Ritwik-main/ESC-tools/circuit_image.png

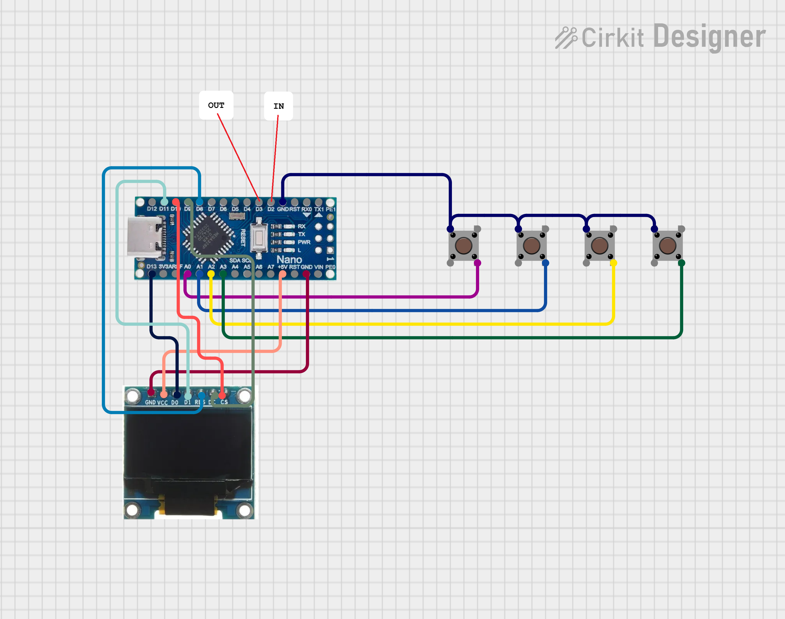
circuit_image.png
