Ritwik-main/ESC-tools/waveforms/0 duty.png

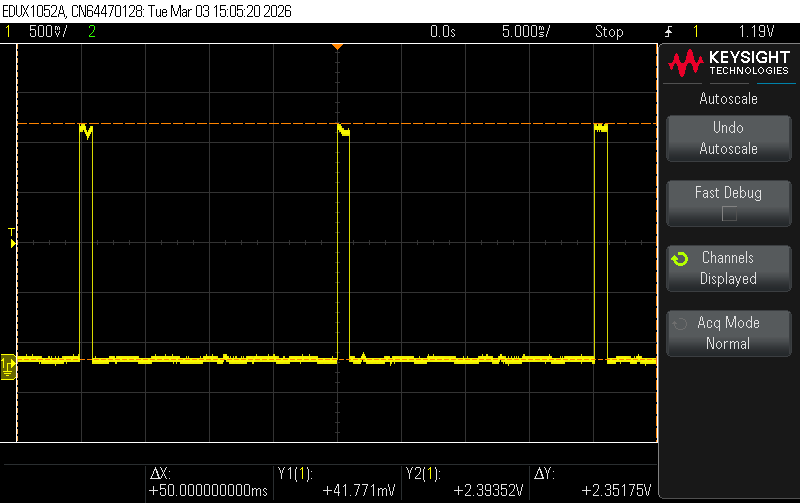
waveforms/0 duty.png
