Ritwik-main/ESC-tools/waveforms/1 Khz.png

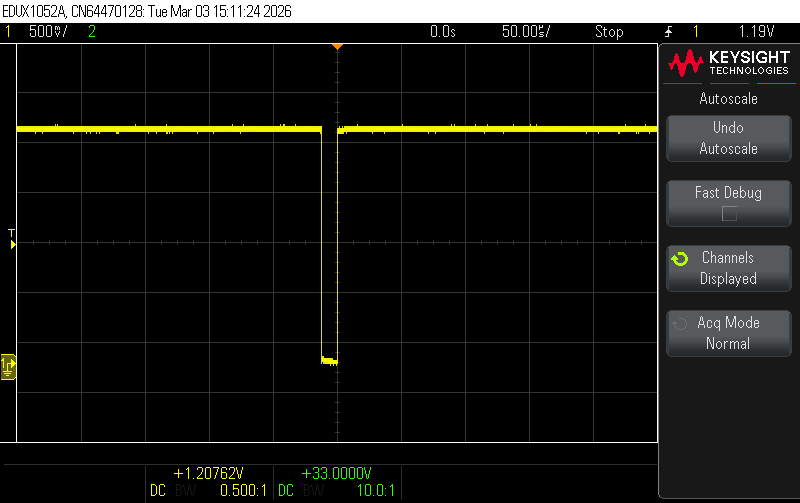
waveforms/1 Khz.png
