Ritwik-main/ESC-tools/waveforms/100 duty.png

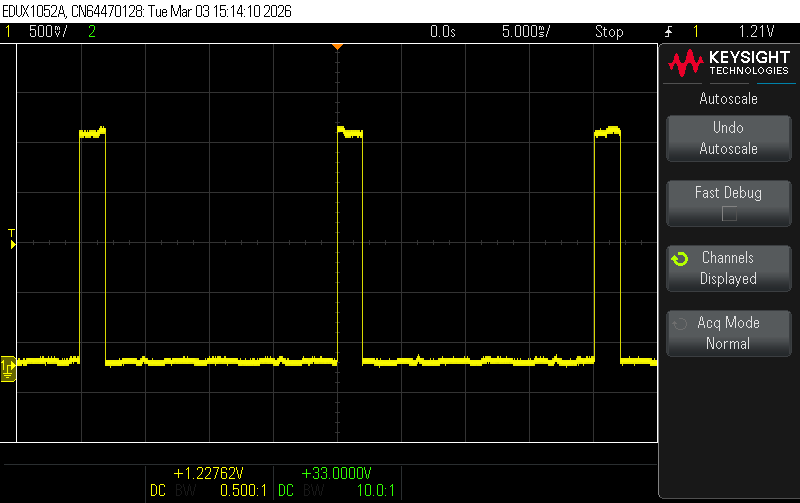
waveforms/100 duty.png
