Ritwik-main/ESC-tools/waveforms/400 hz.png

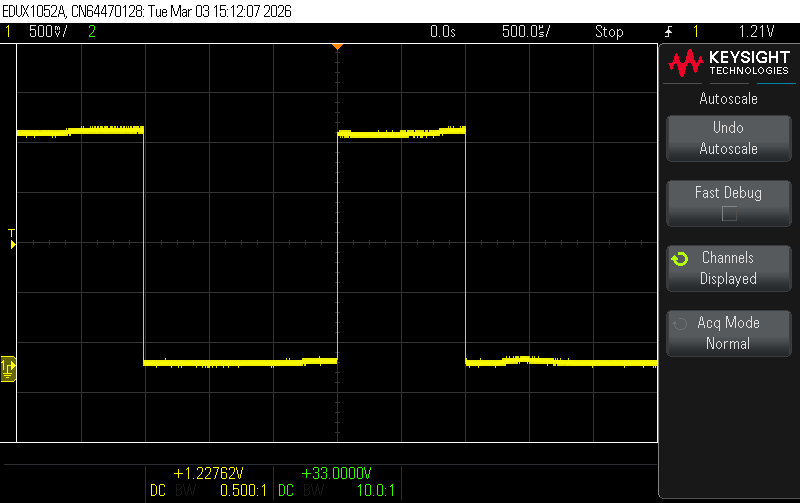
waveforms/400 hz.png
