Ritwik-main/ESC-tools/waveforms/PPM.png

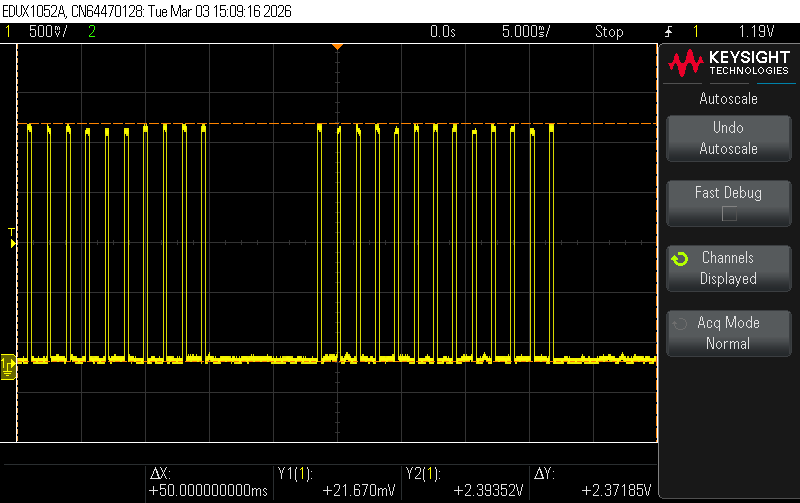
waveforms/PPM.png
