Ritwik-main/ESC-tools/(commit log)

2026-02-27 Revise README for ESC Tools with detailed features
    Expanded the README to provide detailed features, hardware setup, installation instructions, and usage guidelines for the ESC Debugger & Signal Tool.
2026-02-27 Add circuit image to README
    Added an image of the circuit to the README.
2026-02-27 Add files via upload
    add .ino for arduino IDE and Circuit
2026-02-27 Enhance README with additional device support
    Updated project description to include Servo motors, Flight computers, and Stepper motors.
2026-02-27 Update README with power connection note and roadmap
    Added note about powering the circuit and updated roadmap.
2026-02-27 Cleaning
    Removed commented-out Servo library include and updated display text.
2026-02-27 Include safety precautions in README
    Added safety note regarding actuator handling before use.
2026-02-27 modify button logic for QOL
2026-03-05 Subfolder
    Added subfolder for direct Arduino IDE compatibility
2026-03-07 Add Noisy Signal feature with jitter and dropped frames, update docs
    [ESC_TOOL.ino]
2026-07-25 Fix PWM timing corruption at high output rates
    The output waveform degraded above ~500Hz. Three independent causes:
    1. 600Hz and 1000Hz cannot carry a servo-width pulse at all. The period was
    shorter than the pulse and the clamp in updatePWMParams() silently trimmed
    the width to top-10 ticks, yielding a ~99.5% duty line with a 5us notch
    instead of PWM. Rates are now capped to 1e6/(maxPulse + 50us guard) --
    ~487Hz at the 2000us standard -- and out-of-range options are skipped when
    cycling rather than offered and then clipped. The Settings screen shows the
    ceiling. Stored EEPROM rates of 600/1000 are clamped down on load.
    2. OCR1A/OCR1B were written mid-cycle from the main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
    [ESC_TOOL.ino]
2026-07-25 Add OneShot125 support, reclaim flash and RAM, document waveforms
    Adds a scaled output protocol and pays for it by removing the Serial debug
    output. Measured on arduino:avr:nano: 28,170 B flash / 815 B RAM before,
    27,692 B / 529 B after.
    OneShot125:
    - New Protocol setting (Standard / OneShot125). OneShot switches Timer 1 to
    prescaler /1 (0.0625us per tick) and rescales the throttle range into
    125-250us, moving the rate ceiling from ~487Hz to ~3333Hz.
    - The rescale happens only in updatePWMParams(), at the single point where a
    width becomes timer ticks, so every existing mode keeps driving
    currentThrottle in the settings' own microsecond domain and works unchanged.
    - oneShotTicks() i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
2026-07-25 Revert "Merge pull request #2 from Ritwik-main/oneshot125-and-flash-budget"
    This reverts commit 5601837ad1b88e22779d3b68d616231bec819bf6, reversing
    changes made to 971e7a7799ff91586ef5f1b3de34b355c283ca12.
    [ESC_TOOL.ino]
